zykure/diy-synth/README.md

# diy-synth

Schematics and related files for DIY modular synthesizer components.

## MS-20 VCF

[A voltage controller filter based on the Korg MS-20 design.](./VCF_MS-20)

## AS3340 VCO
