zykure/diy-synth/VCF_MS-20/README.md

# diy-synth

Schematics and related files for DIY modular synthesizer components.

## MS-20 VCF

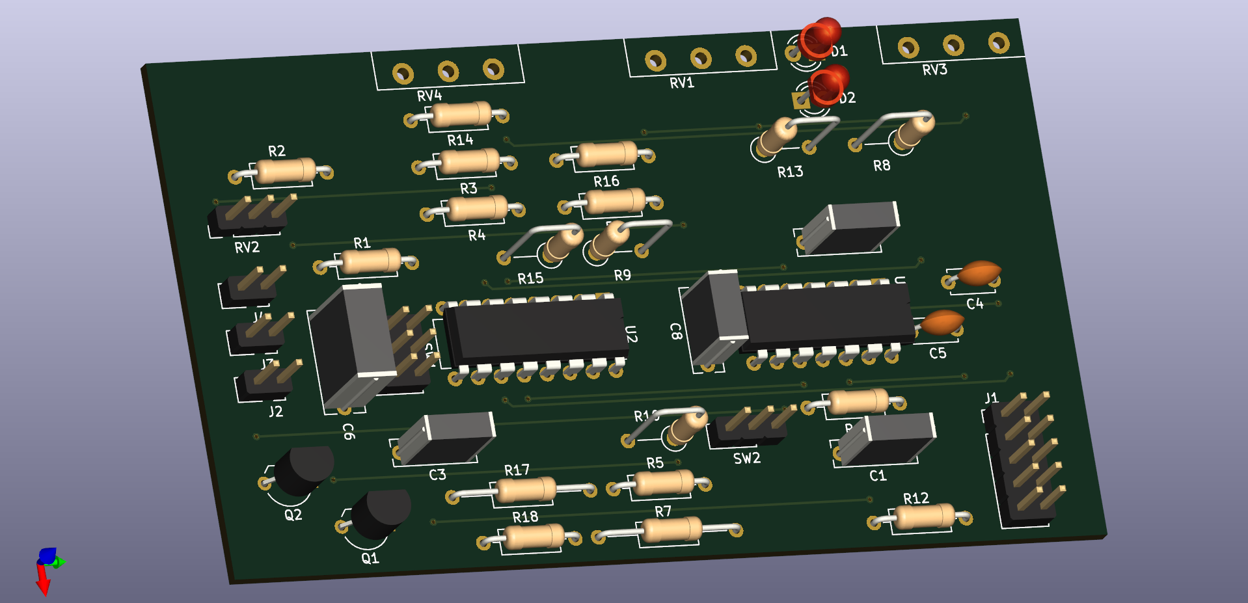
[picture p1: VCF_MS-20/pictures/VCF_MS-20_front_3d.png]
MS-20 PCB, 3D view


A voltage controlled filter based on the "late" Korg MS-20 design. Original design schematics from [Rene Schmitz](https://www.schmitzbits.de/ms20.html) and [Eddy Bergman](https://www.eddybergman.com/2019/12/synthesizer-build-part-12-korg-ms20.html?m=1).

**Working Falstad circuit simulation (online):** [click here][1]

### Features

* Designed for Eurorack format with a 6 HP frontplate and standard +/- 12 V power supply.
* Frontplate potentiometers to control filter cutoff, resonance, input level, and cutoff CV amount.
* Input jacks for source audio signal and cutoff CV; output jack for filtered audio signal.
* Quad opamp (LM324N) and dual OTA (LM13700) in the main circuit.
* LEDs in the resonance feedback circuit indicate resonance "drive".

### Layout

* Circuit schematics: [VCF_MS-20_plan.pdf](./schematics/VCF_MS-20_plan.pdf)
* Board layout: [VCF_MS-20_pcb.pdf](./schematics/VCF_MS-20_pcb.pdf) ([*mirrored*](./schematics/VCF_MS-20_pcb_mir.pdf))
   * The board is a 21 x 36 hole (56 x 97 mm) perforated PCB that should fit in most Eurorack cases. The required depth is about 60 mm.
* Board layout with frontplate design: [VCF_MS-20_pcb_all.pdf](./schematics/VCF_MS-20_pcb_all.pdf)
   * The frontplate is designed for Eurorack cases and has a size of 3 U x 6 HP (127 x 30.5 mm)

### Components (BOM)

*Estimated costs ~ 25 Euro* (in Germany, as of Nov 2023)

|Item |Qty  |Reference(s) |Value |Datasheet |Note |
|----:|----:|---:|---:|---|---|
| 1| 1| C1| 4.7n|~ | |
| 2| 2| C2, C3| 1.0n|~ |film cap. |
| 3| 2| C4, C5| 100n|~ | |
| 4| 1| C6| 1.0u|~ |optional |
| 5| 1| C8| 470n|~ |film cap. |
| 6| 2| D1, D2| LED|~ | |
| 7| 1| J1| POWER|~ | |
| 8| 1| J2| AUDIO IN|~ | |
| 9| 1| J3| AUDIO OUT|~ | |
| 10| 1| J4| CV IN|~ | |
| 11| 2| Q1, Q2| BC558C|https://www.onsemi.com/pub/Collateral/BC556BTA-D.pdf|matched |
| 12| 1| R1| 200k|~ |optional |
| 13| 2| R2, R3| 100k|~ | |
| 14| 6| R4, R5, R6, R7, R9, R10| 10k|~ | |
| 15| 1| R8| 8.2k|~ |or trimpot |
| 16| 1| R11| 4.7k|~ | |
| 17| 1| R12| 470k|~ | |
| 18| 1| R13| 2.2k|~ | |
| 19| 1| R14| 1.5k|~ | |
| 20| 4| R15, R16, R17, R18| 220|~ | |
| 21| 2| RV1, RV4| 100k / log.|~ |Resonance/Input level ctrl.|
| 22| 2| RV2, RV3| 100k / lin.|~ |Cutoff/CV amount ctrl.|
| 23| 1| SW1| SW_DPDT_x2|~ |HP/LP mode |
| 24| 1| SW2| SW_SPDT|~ |6/12 dB falloff|
| 25| 1| U1| LM324|http://www.ti.com/lit/ds/symlink/lm2902-n.pdf | |
| 26| 1| U2| LM13700|http://www.ti.com/lit/ds/symlink/lm13700.pdf | |

Notes:
* Use film capacitors in the audio signal path, not ceramic ones. (Ceramic ones have a voltage dependency that causes distortions.)
* The feedback resistor R8 may be tuned to change the resonance characteristics, e.g. a trimpot could be used instead of a fixed resistor. Check out the [circuit simulation][1] to see what this does.
* For best results, the two transistors should be matched by their hFE value as good as possible. This can usually be done with a simple multimeter with transistor tester.
* A passive low-pass filter (R1/C6) is added at the audio input to remove any DC voltage offset. This is completely optional and the components could be removed from the circuit.

[1]: https://falstad.com/circuit/circuitjs.html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
