zykure/diy-synth/VCF_MS-20/pictures/VCF_MS-20_back.png

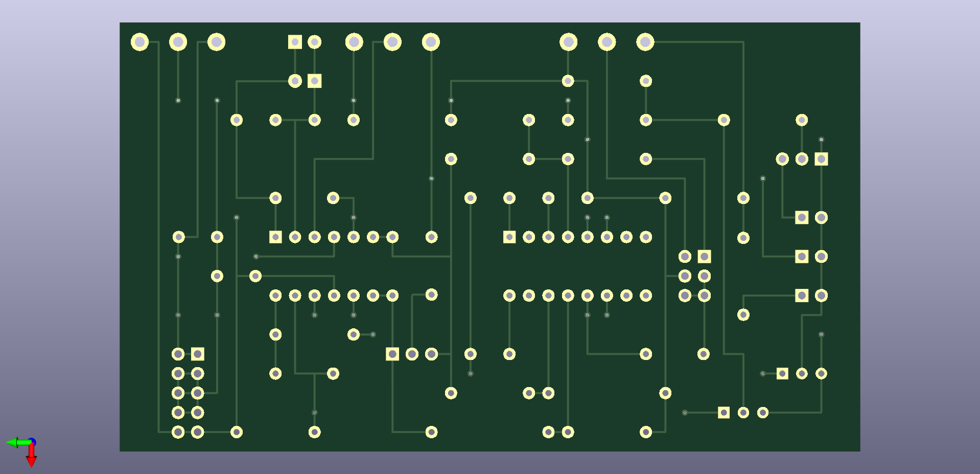
VCF_MS-20/pictures/VCF_MS-20_back.png
