zykure/diy-synth/VCF_MS-20/pictures/VCF_MS-20_front.png

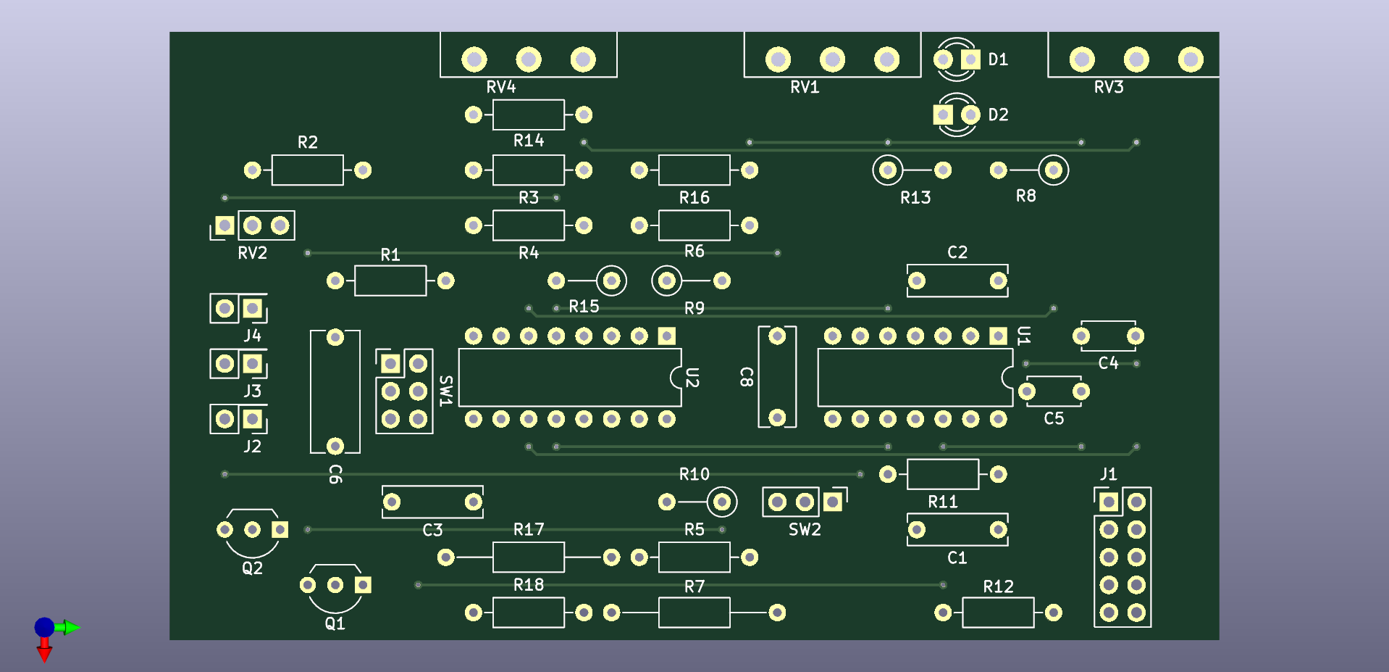
VCF_MS-20/pictures/VCF_MS-20_front.png
