zykure/diy-synth/VCF_MS-20/schematics/VCF_MS-20_pcb.pdf

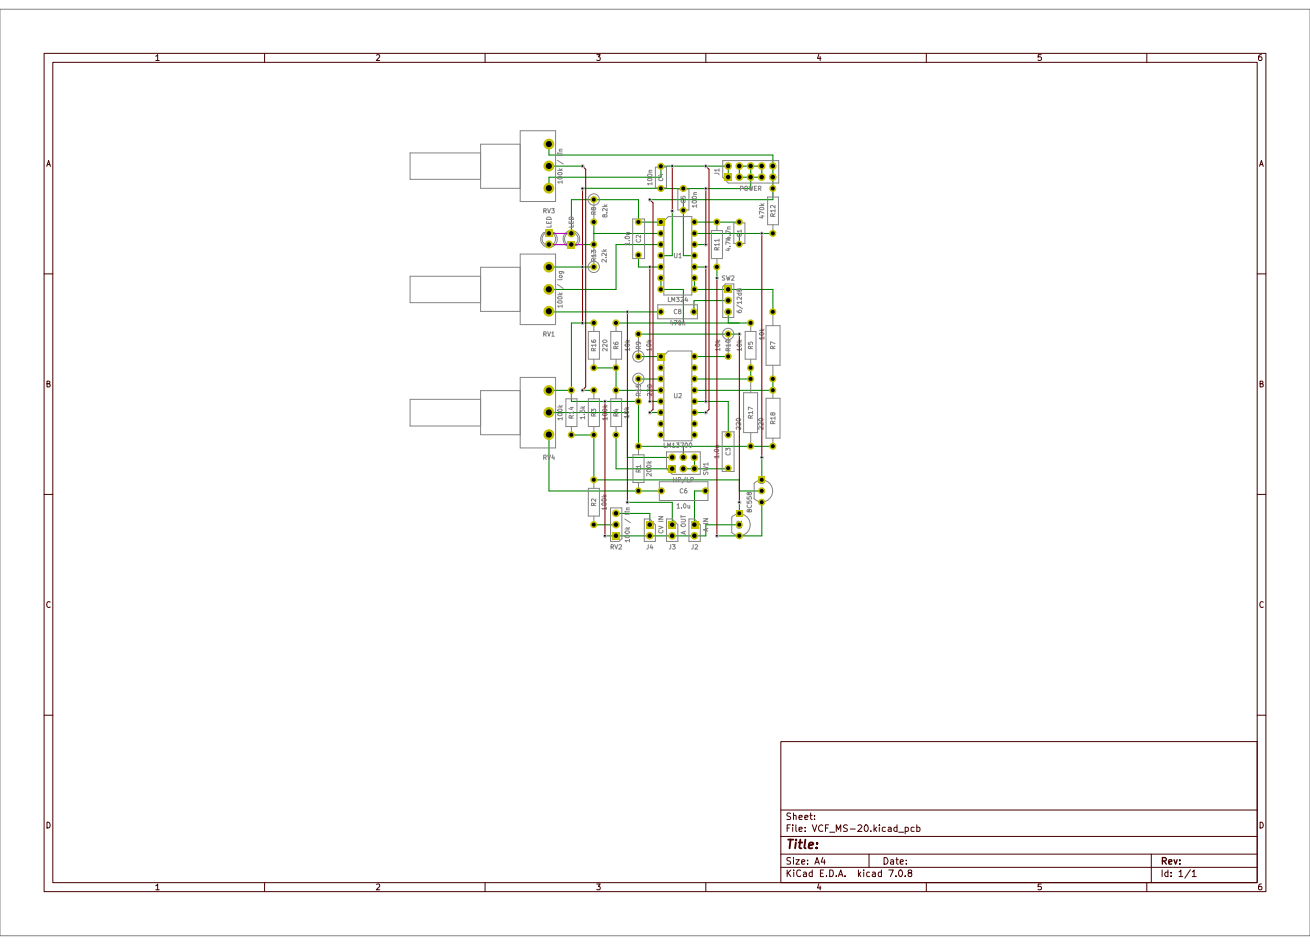
[picture p4: page 1]
