zykure/diy-synth/VCF_MS-20/schematics/VCF_MS-20_pcb_all.pdf

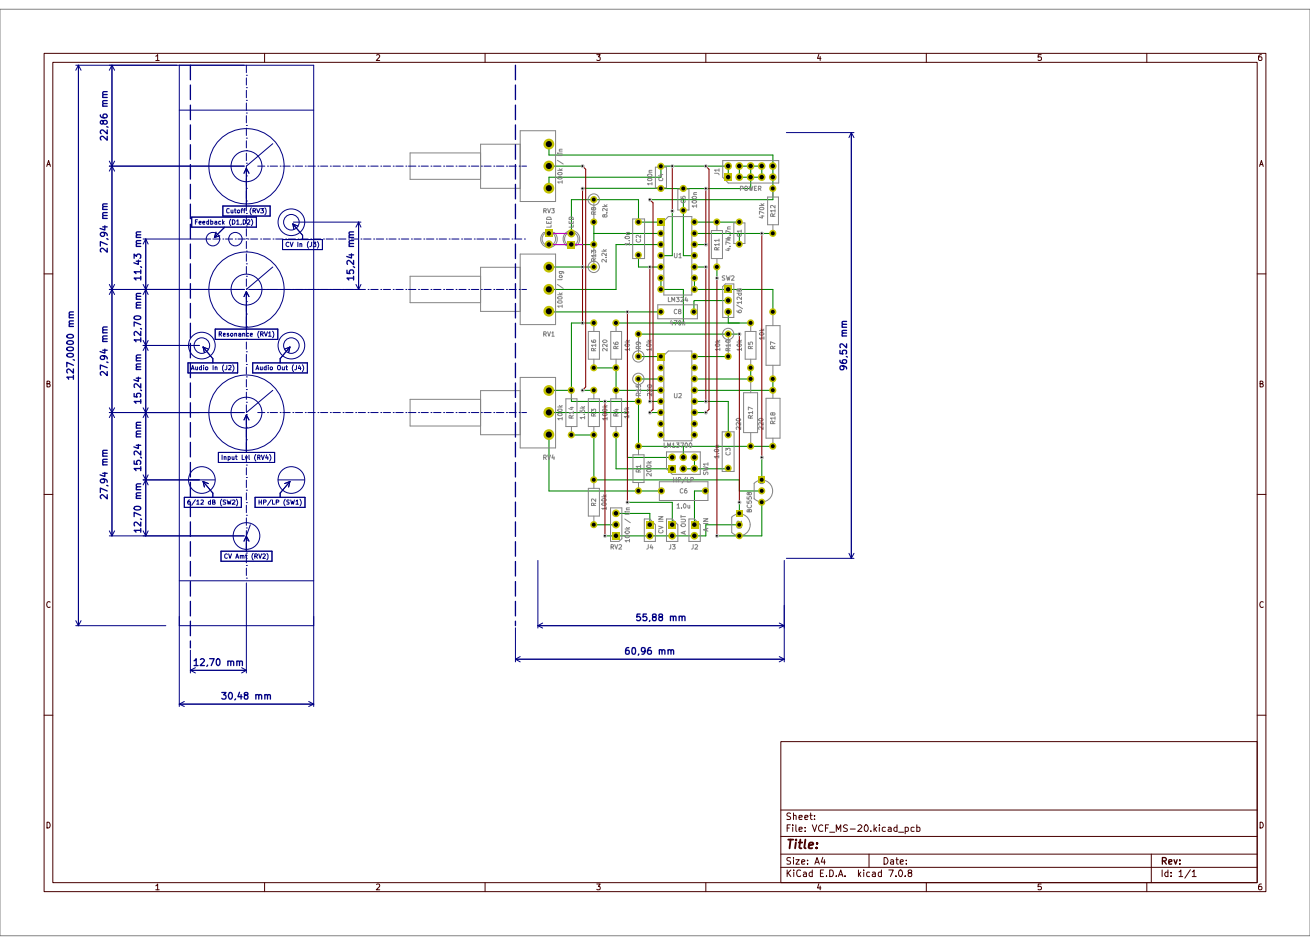
[picture p5: page 1]
