zykure/diy-synth/VCF_MS-20/schematics/VCF_MS-20_pcb_mir.pdf

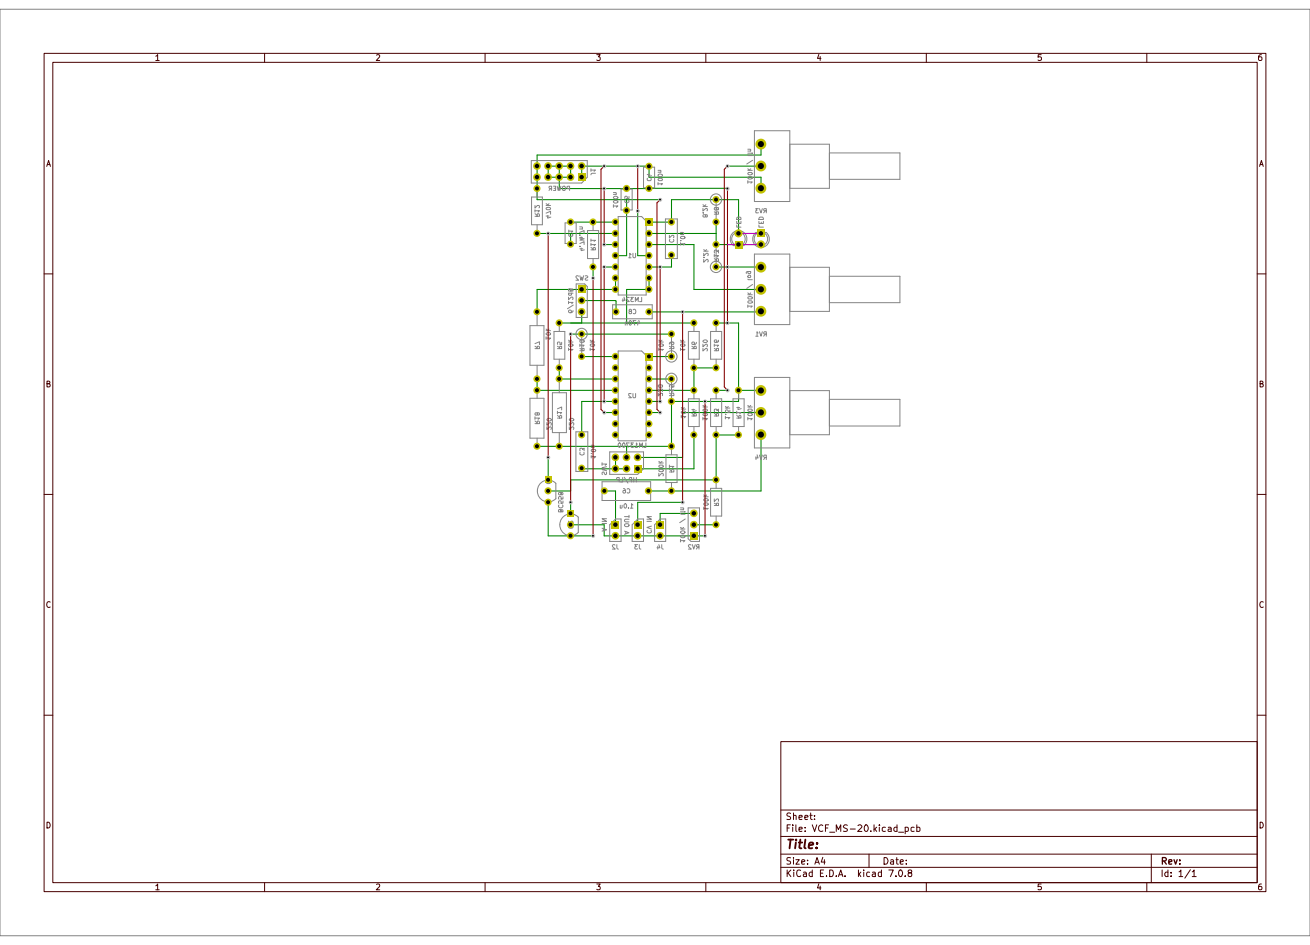
[picture p6: page 1]
