zykure/diy-synth/VCF_MS-20/schematics/VCF_MS-20_plan.pdf

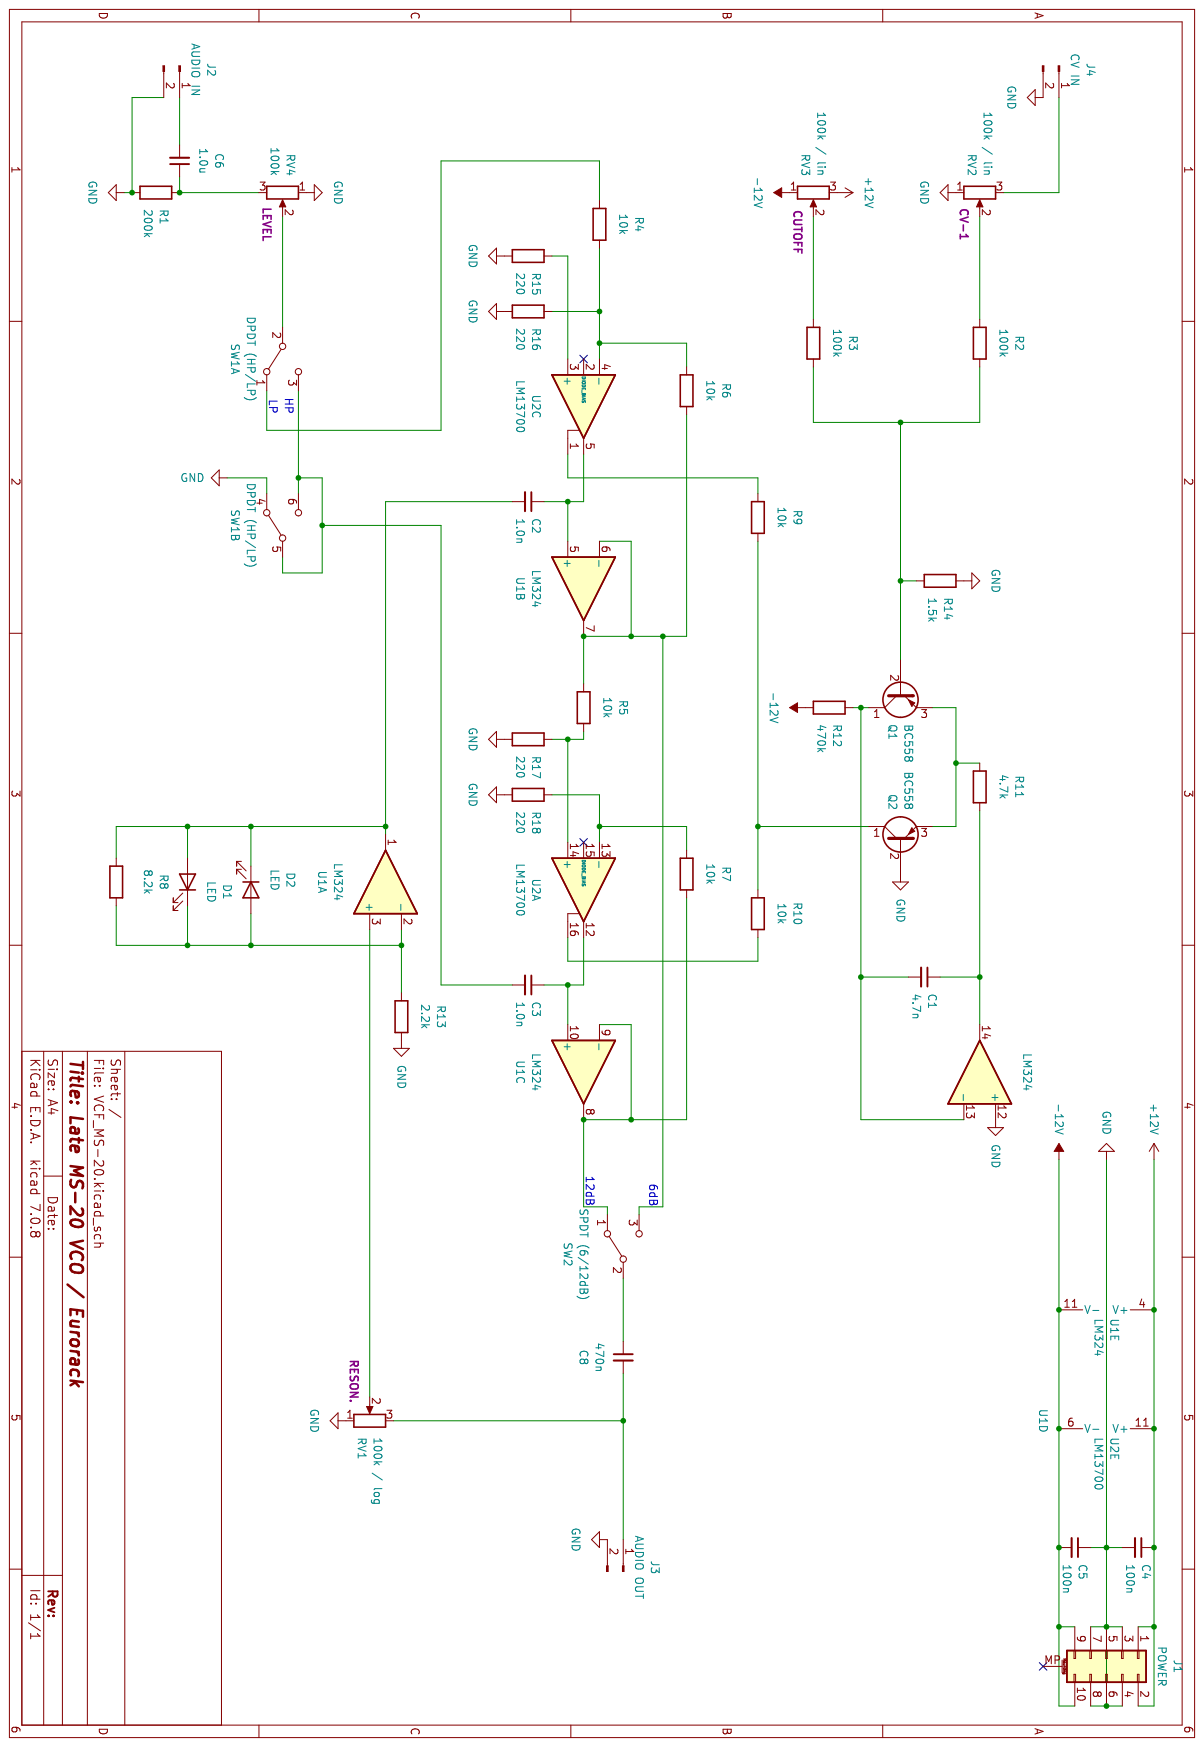
[picture p7: page 1]
