zykure/diy-synth/VCF_MS-20/VCF_MS-20.kicad_pcb

## KiCad design VCF_MS-20/VCF_MS-20.kicad_pcb (2023-11-14)

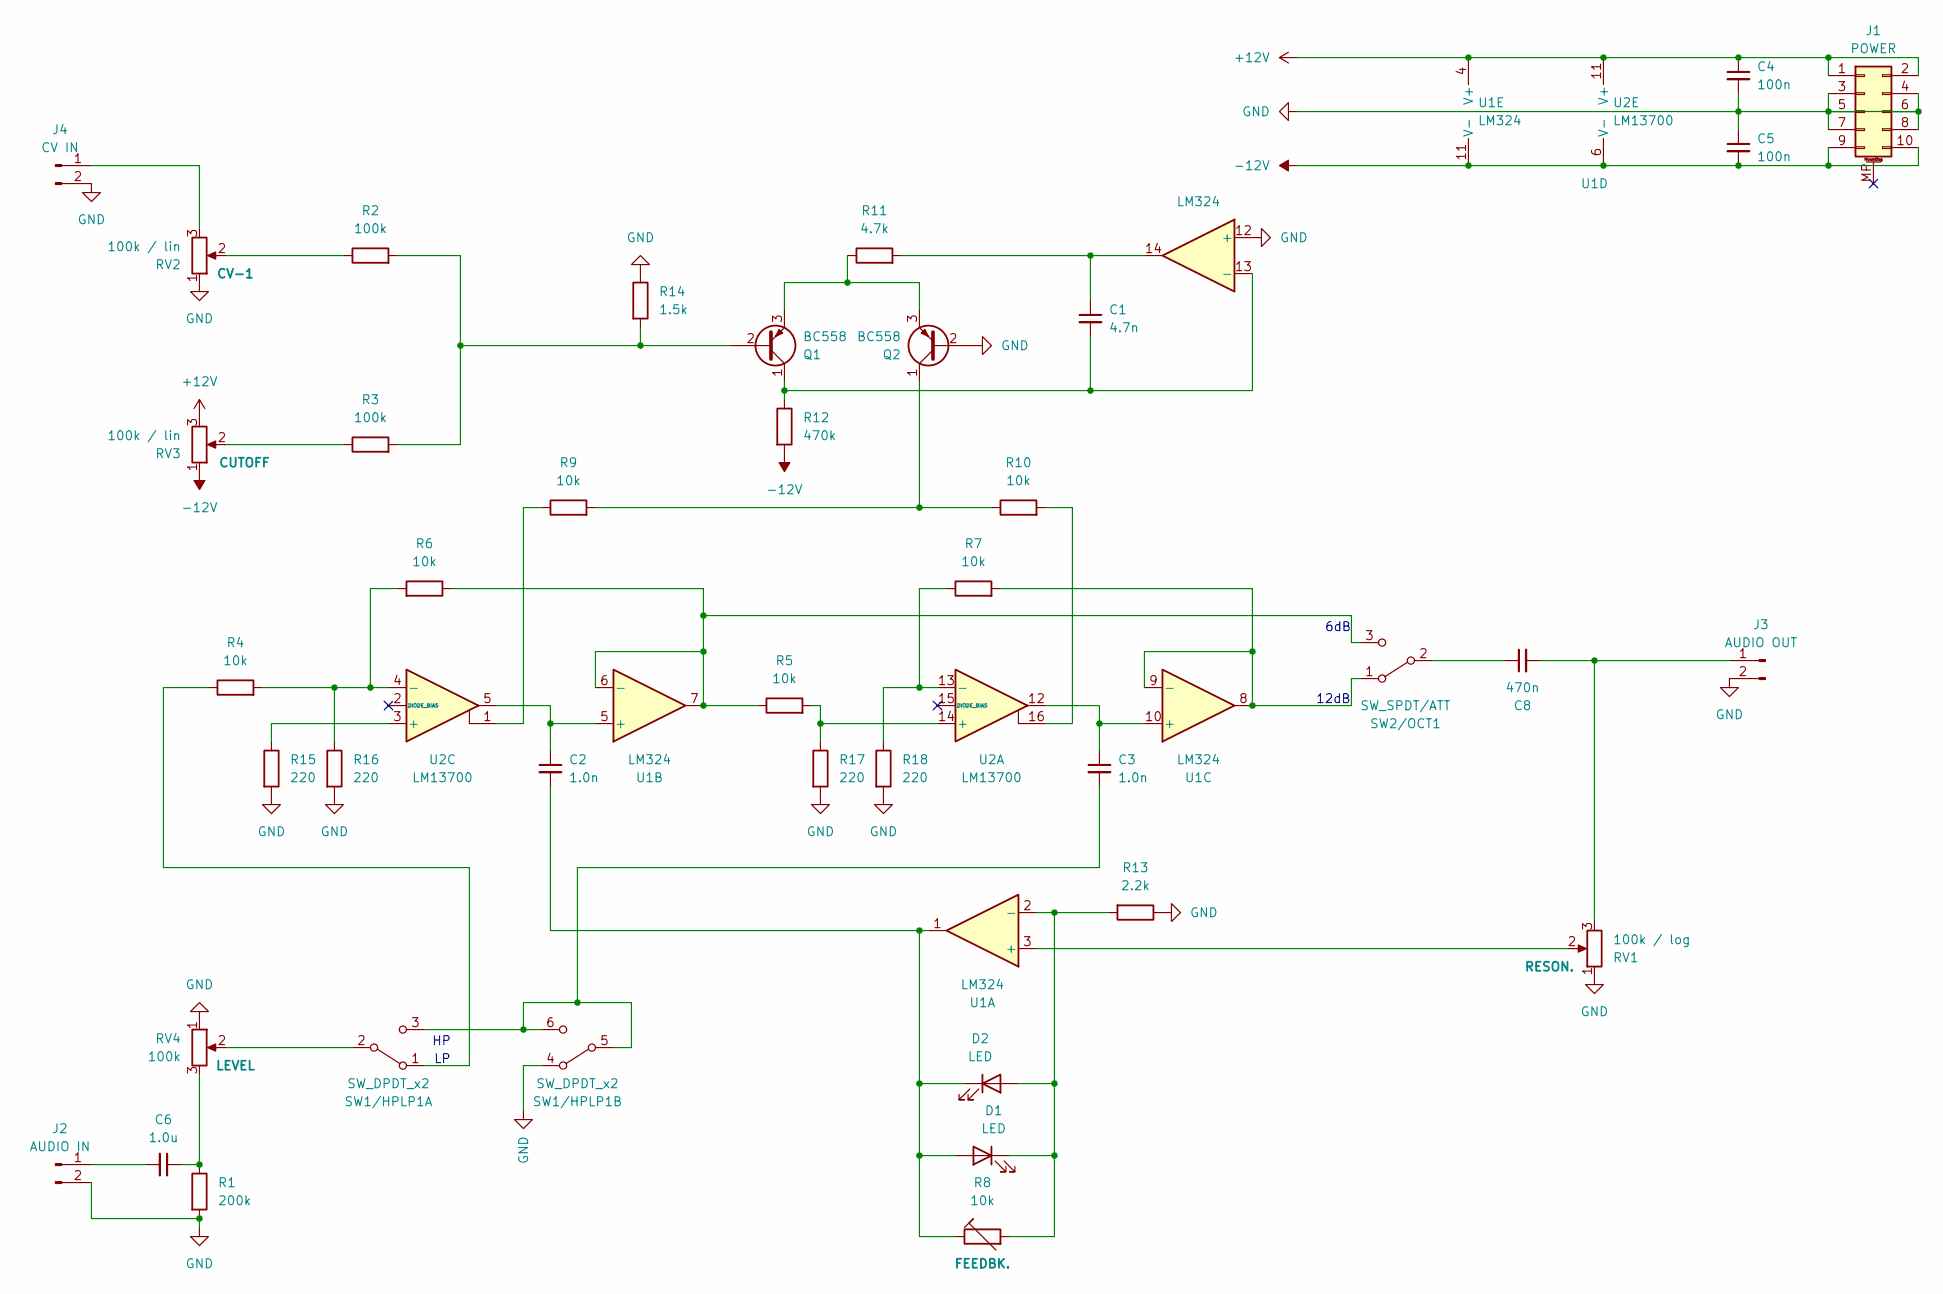
[picture p8: schematic VCF_MS-20.kicad_sch, Late MS-20 VCO / Eurorack]

Parts:
C1: 4.7n; C_Disc_D7.5mm_W2.5mm_P5.00mm
C2, C3: 1.0n; C_Disc_D7.5mm_W2.5mm_P5.00mm
C4, C5: 100n; C_Disc_D7.5mm_W2.5mm_P5.00mm
C6: 1.0u; C_Disc_D7.5mm_W2.5mm_P5.00mm
C8: 470n; C_Disc_D7.5mm_W2.5mm_P5.00mm
D1, D2: LED; LED_D3.0mm
J1: POWER; PinHeader_2x05_P2.54mm_Vertical
J2: AUDIO IN; PinHeader_2x01_P2.54mm_Vertical
J3: AUDIO OUT; PinHeader_2x01_P2.54mm_Vertical
J4: CV IN; PinHeader_2x01_P2.54mm_Vertical
Q1, Q2: BC558; TO-92_Inline_Wide
R1: 200k; R_Axial_DIN0207_L6.3mm_D2.5mm_P15.24mm_Horizontal
R2, R3: 100k; R_Axial_DIN0207_L6.3mm_D2.5mm_P15.24mm_Horizontal
R4, R5, R6, R7, R9, R10: 10k; R_Axial_DIN0207_L6.3mm_D2.5mm_P15.24mm_Horizontal
R8: 10k
R11: 4.7k; R_Axial_DIN0207_L6.3mm_D2.5mm_P15.24mm_Horizontal
R12: 470k; R_Axial_DIN0207_L6.3mm_D2.5mm_P15.24mm_Horizontal
R13: 2.2k; R_Axial_DIN0207_L6.3mm_D2.5mm_P15.24mm_Horizontal
R14: 1.5k; R_Axial_DIN0207_L6.3mm_D2.5mm_P15.24mm_Horizontal
R15, R16, R17, R18: 220; R_Axial_DIN0207_L6.3mm_D2.5mm_P15.24mm_Horizontal
RV1: 100k / log; Potentiometer_TT_P0915N
RV2, RV3: 100k / lin; Potentiometer_TT_P0915N
RV4: 100k; Potentiometer_TT_P0915N
SW1/HPLP1: SW_DPDT_x2; PinHeader_2x03_P2.00mm_Vertical
SW2/OCT1: SW_SPDT/ATT; PinHeader_1x03_P2.00mm_Vertical
U1: LM324; DIP-14_W7.62mm
U2: LM13700; DIP-16_W7.62mm

Connections:
+12V: C4.1, J1.1, J1.2, RV3.3, U1.4 (V+), U2.11 (V+)
-12V: C5.2, J1.9, J1.10, R12.2, RV3.1, U1.11 (V-), U2.6 (V-)
GND: C4.2, C5.1, J1.3, J1.4, J1.5, J1.6, J1.7, J1.8, J2.2, J3.2, J4.2, Q2.2 (B), R1.2, R13.1, R14.1, R15.2, R16.2, R17.2, R18.2, RV1.1, RV2.1, RV4.1, SW1/HPLP1.4 (A), U1.12 (+)
unnamed: C1.1, R11.2, U1.14
unnamed: C6.1, R1.1, RV4.3
unnamed: C2.2, D1.2 (A), D2.1 (K), R8.1, U1.1
unnamed: D1.1 (K), D2.2 (A), R8.2, R13.2, U1.2 (-)
unnamed: C6.2, J2.1
unnamed: C8.2, J3.1, RV1.3
unnamed: J4.1, RV2.3
unnamed: Q1.2 (B), R2.2, R3.2, R14.2
unnamed: C1.2, Q1.1 (C), R12.1, U1.13 (-)
unnamed: Q1.3 (E), Q2.3 (E), R11.1
unnamed: Q2.1 (C), R9.2, R10.1
unnamed: R2.1, RV2.2
unnamed: R3.1, RV3.2
unnamed: R9.1, U2.1
unnamed: R10.2, U2.16
unnamed: R4.1, SW1/HPLP1.1 (A)
unnamed: RV4.2, SW1/HPLP1.2 (B)
unnamed: C3.2, SW1/HPLP1.3 (C), SW1/HPLP1.5 (B), SW1/HPLP1.6 (C)
unnamed: R7.2, SW2/OCT1.1 (A), U1.8, U1.9 (-)
unnamed: C8.1, SW2/OCT1.2 (B)
unnamed: R5.1, R6.1, SW2/OCT1.3 (C), U1.6 (-), U1.7
unnamed: RV1.2, U1.3 (+)
unnamed: C2.1, U1.5 (+), U2.5
unnamed: C3.1, U1.10 (+), U2.12
unnamed: R5.2, R17.1, U2.14 (+)
unnamed: R7.1, R18.1, U2.13 (-)
unnamed: R15.1, U2.3 (+)
unnamed: R4.2, R6.2, R16.1, U2.4 (-)

Notes on the sheet:
6dB
12dB

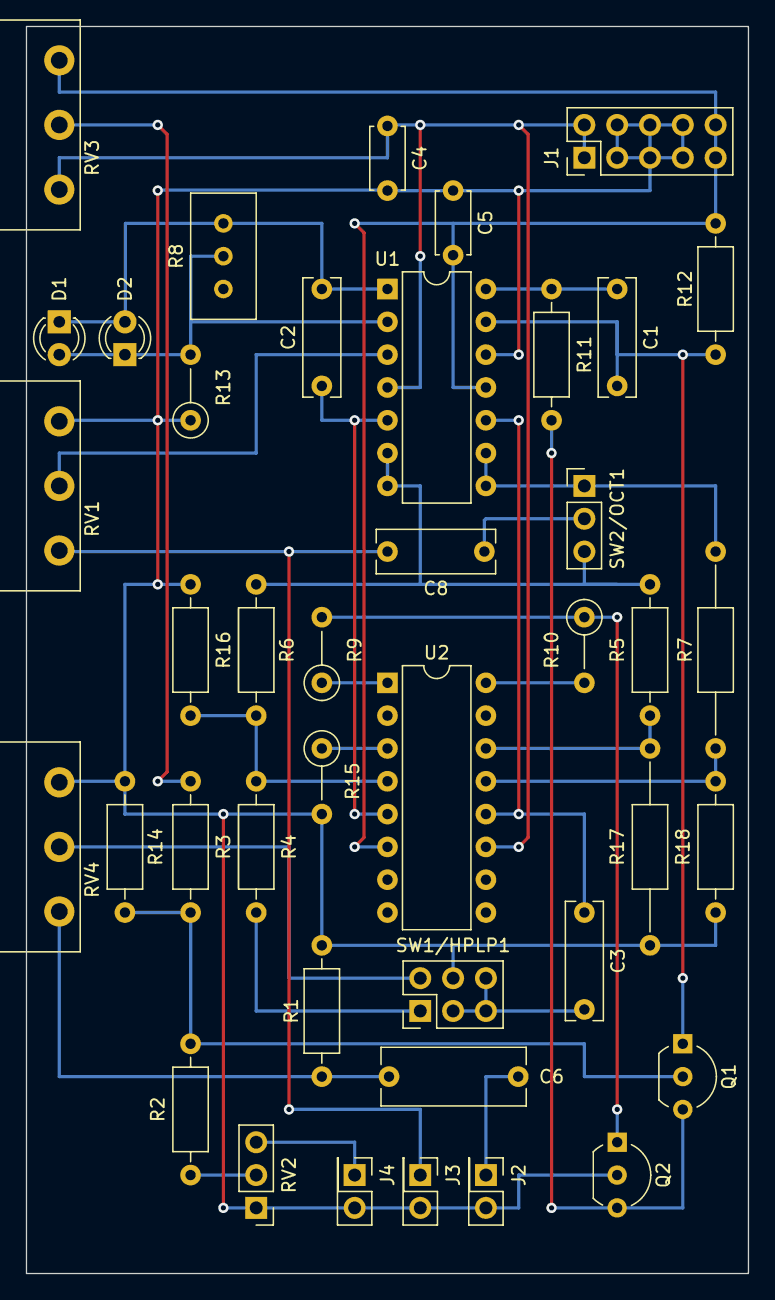
[picture p9: board VCF_MS-20.kicad_pcb from above]

Board: 2 copper layers, 55.9 x 96.5 mm, 41 parts (0 on the bottom side), 31 nets.
