zykure/diy-synth/(commit log)

2023-11-09 [VCF] Add KiCad files
    [VCF_MS-20.kicad_pcb, VCF_MS-20.kicad_sch]
2023-11-09 Update MS-20 VCO
    [VCF_MS-20.kicad_pcb, VCF_MS-20.kicad_sch, VCO_AS3340.kicad_pcb, VCO_AS3340.kicad_sch]
2023-11-09 Update pcb
    [VCF_MS-20.kicad_pcb]
2023-11-20 Update pcb, change R8, add mirror view
